iwonder77/piston-interactive/docs/piston_interactive_schematic.pdf

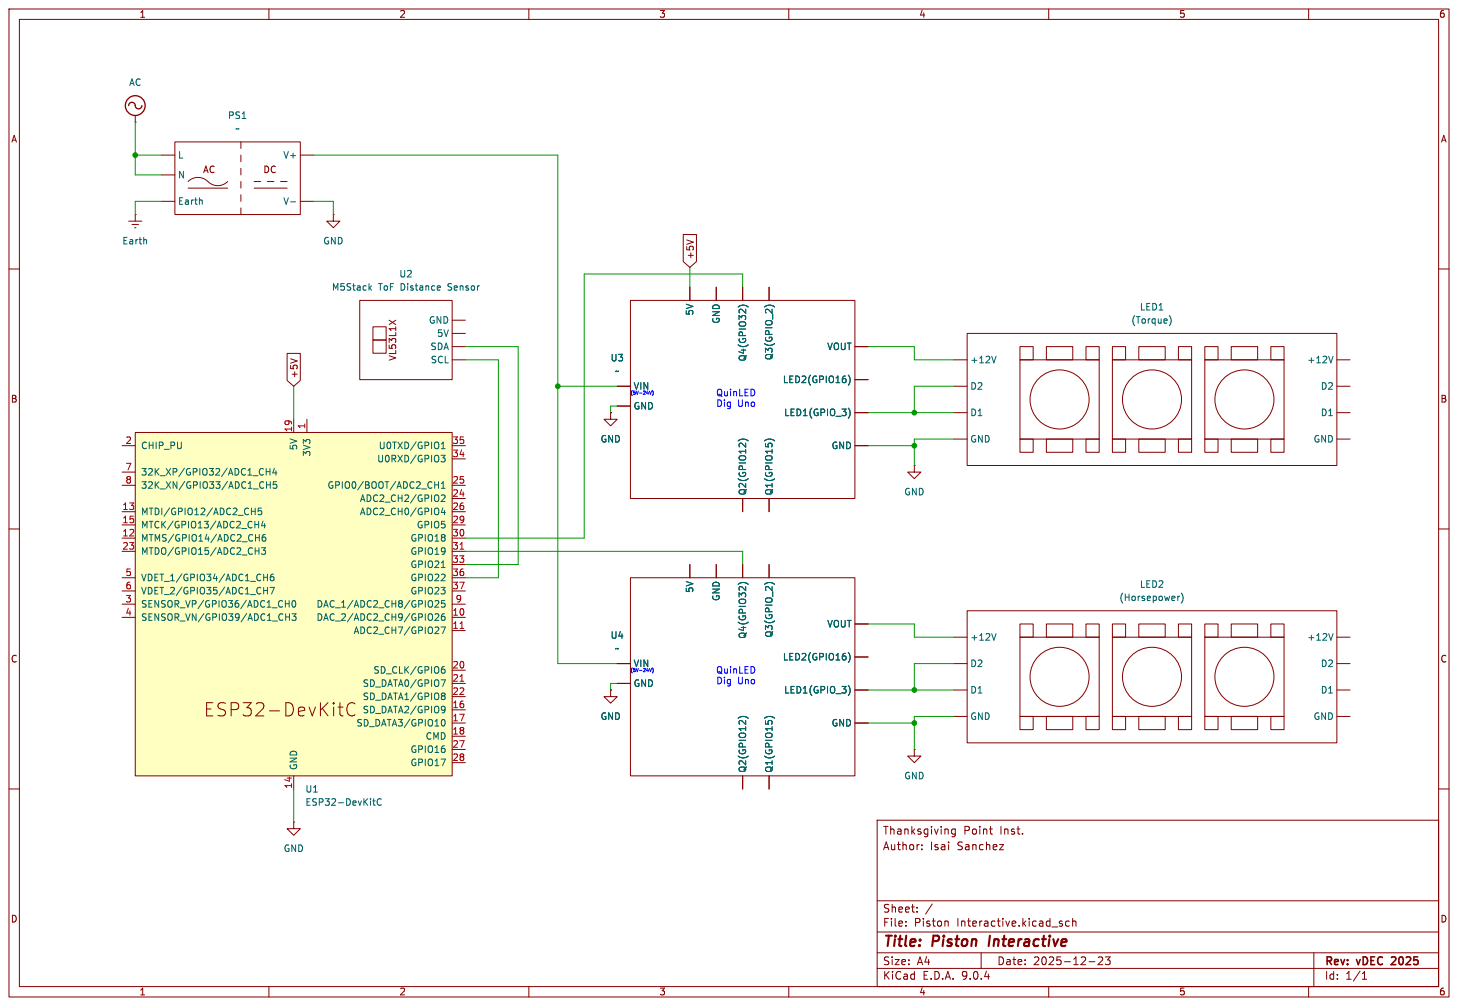
[picture p3: page 1]

1 U0TXD/GPIO1 35 U0RXD/GPIO3 34 GPIO0/BOOT/ADC2_CH1 25 ADC2_CH2/GPIO2 24 ADC2_CH0/GPIO4 26 GPIO5 29 GPIO18 30 GPIO19 31 GPIO21 33 GPIO22 36 GPIO23 37 DAC_1/ADC2_CH8/GPIO25 9 DAC_2/ADC2_CH9/GPIO26 10 ADC2_CH7/GPIO27 11 SD_CLK/GPIO6 20 SD_DATA0/GPIO7 21 SD_DATA1/GPIO8 22 SD_DATA2/GPIO9 16 SD_DATA3/GPIO10 17 CMD 18 GPIO16 27 GPIO17 28 U1ESP32-DevKitC +5V +5V GND

U2 M5Stack ToF Distance Sensor ESP32-DevKitC 5V 19 GND 14 CHIP_PU 2

Id: 1/1 Title: Piston Interactive
