iwonder77/piston-interactive/piston-dynamics/src/Config.h

#pragma once
/**
 * Config.h
 *
 * Centralized configuration constants used by the esp32 sketch.
 * - make sure to `#include "Config.h"` then use config::XXXXX
 * - units are encoded in the name (e.g. _MS, _US)
 */

#include <Arduino.h>

namespace config {
enum class PistonSize : uint8_t { SMALL, MEDIUM, LARGE };

// ===== SET PER INSTALLATION - see README "Deployment & Maintenance" =====
// NOTE: this is the only constant that differs between the three exhibits. It
// sets the PWM duty ceiling so each unit's bar reaches a visibly different
// height at the same RPM. The value is echoed in the boot banner on serial.
constexpr PistonSize DISPLAY_TYPE = PistonSize::SMALL;

/**
 * @brief Human readable name for a variant, used by the boot banner.
 *
 * @param size variant to name
 * @return static string, never null
 */
static inline const char *pistonSizeName(PistonSize size) {
  switch (size) {
  case PistonSize::SMALL:
    return "SMALL";
  case PistonSize::MEDIUM:
    return "MEDIUM";
  case PistonSize::LARGE:
    return "LARGE";
  }
  return "UNKNOWN";
}

// --- WATCHDOG & BUS TIMEOUTS ---
constexpr uint32_t WDT_TIMEOUT_MS = 5000;
constexpr uint32_t WDT_IDLE_CORE_MASK = (1 << 0);
// NOTE: the ToF sensor sits on the default I2C bus - GPIO 21 (SDA) and
// GPIO 22 (SCL). Wire.begin() is called with no arguments, so those pins come
// from the ESP32 core and are deliberately not redefined here.
constexpr uint16_t I2C_TIMEOUT_MS = 100;

// --- VL53L1X ---
constexpr uint16_t SENSOR_TIMEOUT_MS = 500; // VL53L1X timeout
constexpr uint8_t ROI_W = 6;                // 4..16 typical
constexpr uint8_t ROI_H = 6;
constexpr uint8_t ROI_CENTER = 199;
constexpr uint16_t TIMING_BUDGET_US = 15000; // 15 ms budget
constexpr uint16_t SENSOR_POLL_MS = TIMING_BUDGET_US / 1000;
constexpr uint16_t INTER_MEAS_MS = 15; // continuous period

// --- SENSOR READING WINDOW ---
constexpr float MIN_VALID_MM = 20.0f; // 4 cm is lowest reading recommended from
                                      // sensor docs, but let's stick with 2 cm
constexpr float MAX_VALID_MM = 4000.0f; // 4 m

// --- MOTION DETECTION WINDOWS ---
constexpr float MIN_MOTION_DELTA_MM =
    3.0f; // minimum change in position to detect motion (mm)
constexpr uint32_t MOTION_TIMEOUT_MS =
    3000; // reset tracking after this many ms of no motion
constexpr float MIN_REASONABLE_THROW =
    2.0f; // minimum detected throw that makes sense (mm)
constexpr float MAX_REASONABLE_THROW =
    150.0f; // maximum detected throw that makes sense (mm)
constexpr float MIN_THROW_FOR_MOTION_MM =
    2.0f; // minimum throw to consider system "in motion" (mm)
constexpr float MIN_MAX_HYST_MM =
    2.0f; // must exceed previous min/max by this amount (+ or -) to update
constexpr uint16_t PEAK_MIN_MAX_WINDOW_SIZE =
    64; // max ring buffer size for min/max window
constexpr uint16_t PEAK_PERIOD_WINDOW_SIZE =
    6; // max ring buffer size for period count window

// --- CENTER-CROSSING CONSTANTS ---
constexpr uint32_t MIN_HALF_CYCLE_MS = 10;    // minimum realistic half-cycle
constexpr uint32_t MAX_HALF_CYCLE_MS = 10000; // maximum realistic half-cycle

// --- DECAY RPMS CONSTANTS ---
constexpr uint32_t RPM_DECAY_TIMEOUT_MS = 500; // start decay after 0.5s
constexpr float RPM_DECAY_FACTOR = 0.99f;      // decay multiplier
constexpr float RPM_DECAY_MIN = 10.0f;         // zero out below this

// --- ENGINE MODEL ---
// NOTE: DISPLAY_TYPE lives at the top of this file (styleguide 5.2)
constexpr float PISTON_AREA_CM2 = 50.0f;
constexpr float MIN_DETECTED_RPM = 2.0f;
constexpr float MAX_DETECTED_RPM = 200.0f;
constexpr float MAX_DISPLAY_TORQUE = 1200.0f;
constexpr float MAX_DISPLAY_HP = 200.0f;
constexpr float PRESSURE_MULTIPLIER = 0.5f; // simplification factor
constexpr float TORQUE_SCALE_FACTOR =
    0.2f; // scale torque for reasonable LED range

// --- EMA FILTER ---
// (0...1) smaller = heavier smoothing
constexpr float EMA_POS_ALPHA = 0.4f; // position smoothing
constexpr float EMA_RPM_ALPHA = 0.3f; // rpm smoothing

// --- LEDC (PWM) ---
constexpr uint8_t TORQUE_LED_PIN = 18;
constexpr uint8_t HP_LED_PIN = 19;
constexpr uint32_t PWM_FREQ_HZ = 5000; // 5kHz PWM frequency
constexpr uint8_t PWM_RES_BITS = 8;    // 8-bit resolution (0...255)
constexpr uint32_t PWM_MIN_DUTY =
    20; // allow small readings for torque and hp to pass through
// NOTE: although changing the max duty cycle for torque and horsepower pwm
// signals across displays is not technically accurate, the educational impact
// of seeing changes in LED bar height across displays is much higher
constexpr uint16_t SMALL_PISTON_MAX_DUTY = 190;
constexpr uint16_t MEDIUM_PISTON_MAX_DUTY = 220;
constexpr uint16_t LARGE_PISTON_MAX_DUTY = 255;

// --- ERROR HANDLING ---
constexpr uint8_t MAX_SENSOR_ERRORS = 5;
constexpr uint32_t ERROR_RECOVERY_PERIOD = 5000;

// --- UTILITY FUNCTION ---
static inline float clampf(float x, float lo, float hi) {
  return (x < lo) ? lo : (x > hi) ? hi : x;
}
} // namespace config
