iwonder77/piston-interactive/torque-hp-led-driver/src/PwmReader.h

#pragma once
/**
 * PwmReader.h
 *
 * Class to handle input PWM duty cycle measurements using an ISR
 */
#include <Arduino.h>

#include "Config.h"
#include "RingWindow.h"

class PwmReader {
public:
  PwmReader() = default;
  PwmReader(const PwmReader &) = delete;
  PwmReader &operator=(const PwmReader &) = delete;

  /**
   * @brief Simple hardware initialization, ensure instance object pointer
   * points to the right place, then attach interrupt
   * @return true always
   */
  bool init();

  /**
   * @brief Reads the latest PWM measurement and applies
   * the running average using RingWindow
   *
   * @param duty_cycle_pct set to the smoothed duty cycle
   * percentage (0-100) on a successful read
   * @return true when a fresh and valid measurement was available
   */
  bool read(float &duty_cycle_pct);

private:
  RingWindow<float, config::AVERAGE_SAMPLES> duty_cycle_filter_;
  // ----- TIMER INTERRUPT VARIABLES FOR PWM CALC -----
  volatile uint32_t pulse_start_time_ = 0;
  volatile uint32_t pulse_width_ = 0;
  volatile uint32_t last_period_start_ = 0;
  volatile uint32_t period_length_ = 0;
  volatile bool new_data_available_ = false;

  static PwmReader *instance_;
  static void IRAM_ATTR isrTrampoline();
  void IRAM_ATTR handleEdge();
};
