iwonder77/piston-interactive/piston-dynamics/src/Debug.h

#pragma once
/**
 * Debug.h
 *
 * Simple debug logging macros. Set DEBUG_LEVEL to 0 to compile out debug
 * prints.
 */
#ifndef DEBUG_LEVEL
#define DEBUG_LEVEL 1
#endif

#if DEBUG_LEVEL >= 1
#define DEBUG_PRINT(...) Serial.print(__VA_ARGS__)
#define DEBUG_PRINTLN(...) Serial.println(__VA_ARGS__)
#define DEBUG_PRINTF(...) Serial.printf(__VA_ARGS__)
#else
#define DEBUG_PRINT(...)
#define DEBUG_PRINTLN(...)
#define DEBUG_PRINTF(...)
#endif
