iwonder77/piston-interactive/(commit log)

2025-07-25 removed constrain on torque and hp calculations to test raw min and max, then updated the min and max constants accordingly so that PWM signal is mapped more closely to the torque and hp calculations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
2025-07-30 mapping torque and hp calculations to PWM range of 0-255, then constraining the PWM values of torque and hp to not go below 20 (so there is always at least a bit of light) or above 255
2025-08-04 using ledcWrite() instead of analogWrite(), added appropriate variables and other changes to accomodate
2025-08-05 prototype and testing of project was scaled to a more life sized version of piston interactive, so max torque and horsepower readings needed to be adjusted
2025-08-13 restructured repository to hold both esp32 + tof sensor code, along with LED driver code
2025-08-14 added software interrupts on DigUno's input PWM pin (Q4 now) to calculate PWM values from hp and torque faster and more accurately, noticeable decrease in lag between manually driving the piston and 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
2025-08-25 explan of logic/data flow
2025-09-24 Refine motion tracking, sensor config, and LED output mapping
    - Sensor: switched VL53L1X distance mode from Medium → Short, lowered min valid
    reading from 40mm → 20mm, and increased motion delta threshold to 3mm.
    - MotionTracker:
    - Introduced hysteresis band for center-crossing detection.
    - Added period averaging with dedicated ring buffer for more stable RPM
    calculation.
    - Improved reset logic and edge detection to reduce spurious RPM spikes.
    - RingWindow: added average() method for period averaging.
    - Engine model: renamed RPM constants to MIN/MAX_DETECTED_RPM, clamped against
    detection limits instead of display-only limits.
    - LED output: changed PWM mapping to scale betw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
2025-09-25 renamed project folder for esp32
2025-09-25 renamed quinled driver project folder
2025-10-02 changed color order for different order LED strips
2025-10-02 added piston size enum to limit duty cycle for all 3 displays, although not technically accurate the educational impact is higher
2025-11-20 restructured esp32 code into separate files
2025-11-24 Add clangd config for LSP compatibility
    This .clangd file configures clangd (the C++ language server) to work
    properly with Arduino projects. It addresses false-positive errors that
    appear in editors using clangd for LSP features (autocomplete, diagnostics).
    Key fixes:
    - Adds src/ directory to include path (probably not necessary)
    - Suppresses 'file not found' and other inline errors for Arduino core and 3rd party libraries
    - Suppresses overload resolution errors for Serial.print/println
    - Forces C++ mode for .h files (Arduino convention)
    Note: This is purely for editor tooling and does not affect compilation.
    arduino-cli handles the actual build process independently. Feel free to ignore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
2025-11-24 placing Wire.begin() here
2025-11-24 fixed error when calling getter for RPMs
    [App.cpp]
2025-11-24 reset and decayRPM methods are public now
    [MotionTracker.cpp, MotionTracker.h]
2025-11-24 no more dynamic allocation, that was bad, since we know sizes of windows at compile time with the constants in Config.h, we just create a fixed-size array on the stack whenever used
    [RingWindow.h]
2025-11-24 fixed a typo and added more constants to remove magic numbers placed in MotionTracker.cpp file
    [Config.h]
2025-11-24 added variable to hold timestamp of every sensor read, as well as logic to poll the sensor based on the timing budget constant we set in Config.h
2025-11-24 removed small issue with insertion sort
    [RingWindow.h]
2025-12-23 add pdf and jpg schematic files to repository
2025-12-23 add wiring diagram to README
2025-12-23 rename pdf and jpg files of schematic for better use
2025-12-23 fix path for schematic jpg file
2026-08-12 fix: size_t truncation bug when adding a float to the ring window (also style: updated member and local func variables to follow style guide)
    [MotionTracker.cpp, MotionTracker.h]
2026-08-12 fix: removed dead code in hysteresis band check and updated fabs to fabsf since floats are being used
    [MotionTracker.cpp]
2026-08-12 fix: because this class owns hardware, we must ensure copy construction and assignment are deleted
    [ToFSensor.h]
2026-08-12 fix: init() method has replaced configure() method, and has been written so that any time we want to re-initialize this object, we start from scratch with non-stale data
    [ToFSensor.cpp]
2026-08-12 fix: recover() method now properly attempts to re-initialize sensor object instead of copying another one over
    [App.cpp]
2026-08-12 fix: value must be at or greater than timing budget
    [Config.h]
2026-08-13 feat: adding I2C timeout and watchdog config variables
2026-08-13 feat: .clangd file now included in led driver
2026-08-13 fix: debugs now come with guards
    [Debug.h]
2026-08-13 fix: removed unecessary I2C timeout
    [Config.h]
2026-08-13 fix: feed watchdog in LED driver loop() and restore build
    [torque-hp-led-driver.ino]
2026-08-13 pin toolchain/library versions in sketch.yaml and add clang-format config, also removed avr mentions in clangd
2026-08-13 feat: move LED driver tunables into config namespace
2026-08-14 fix: swapping RunningAverage for custom RingWindow to keep things clean n simple
    [RingWindow.h, torque-hp-led-driver.ino]
2026-08-17 refactor: class created to handle pwm duty cycle measurements using ISR
2026-08-17 feat: BarDisplay class for both LED strip animations with fixed-cadence frames and idle-at-boot for the bar
    [BarDisplay.cpp, BarDisplay.h, Config.h, PwmReader.cpp, torque-hp-led-driver.ino]
2026-08-17 style: enum class and camelCase fixes
    [App.cpp, App.h]
2026-08-17 style: making constants fixed width
    [Config.h]
2026-08-18 refactor: split LedOutput into header and implementation It drives hardware PWM channels/pins, so I split it and made it non-copyable. beginPWM renamed to init
2026-08-18 feat: added SENSOR_POLL_MS constant
